kevinnaoko/Heart-Rate-Monitor/README.md

# Heart-Rate-Monitor

Perancangan Heart Rate Monitor dilakukan dengan Arduino dan sensor PPG
